kevin-j-chan/qp-trash-can/(list of files, drawings)

Other design files:
Trash-can-circuit-schematic.fzz
