kevin-j-chan/qp-trash-can/(commit log)

2018-05-21 sample base for project
2018-05-26 New documentation
    Documentation for 5/26/2018. Includes circuit diagram for the product.
    [Trash-can-circuit-schematic.fzz]
2018-06-02 Updated documentation for new circuit diagram
    [Trash-can-circuit-schematic.fzz]
2018-06-03 Update schematic
    [Trash-can-circuit-schematic.fzz]
